JakobThiessen/SmartHome_RelayModul_1Wire_ADC/README.md

# SmartHome_RelayModul_1Wire_ADC

beachte Änderungen in [Hardwarebeschreibung](hardware/readme.md)

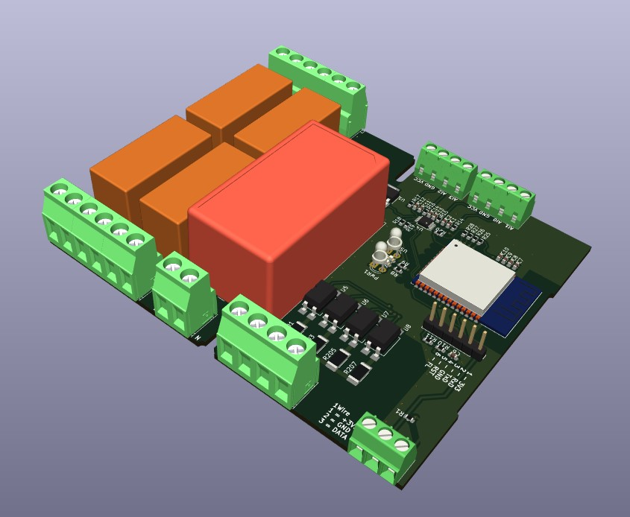
[picture p1: hardware/RelayModul_1Wire_ADC.jpg]
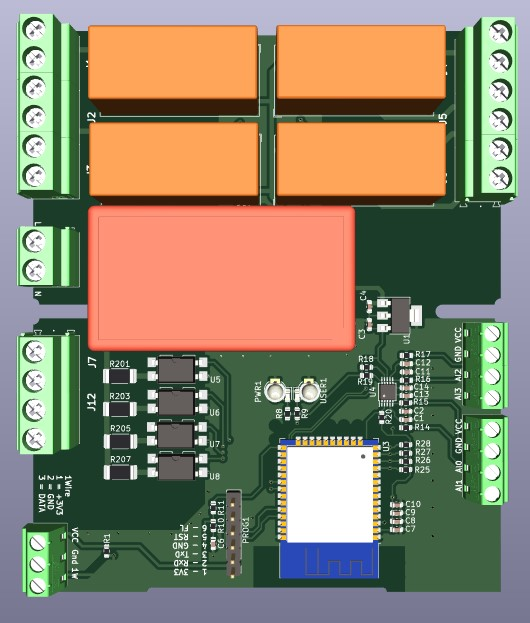
[picture p2: hardware/RelayModul_1Wire_ADC_top.jpg]
  

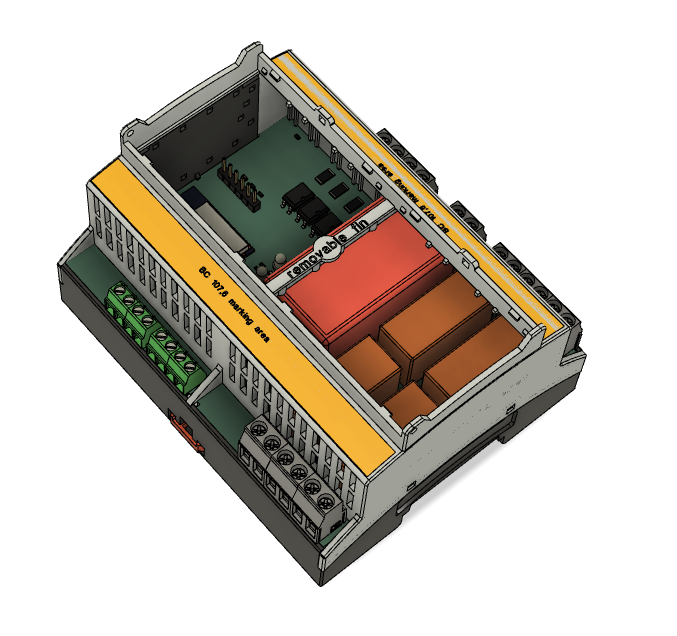
[picture p3: drawings/3d model.png]
