JakobThiessen/SmartHome_RelayModul_1Wire_ADC/hardware/readme.md

# Schaltplan

# Layout

# Bauteile

# Verdrahtungsplan

# Änderungen

Folgende Änderung muss vorgenommen werden:

IO12 kein PullUp (probleme beim booten)

IO34, IO35, IO36 and IO39 --> input only

IO34 --> IO13\
IO35 --> IO25

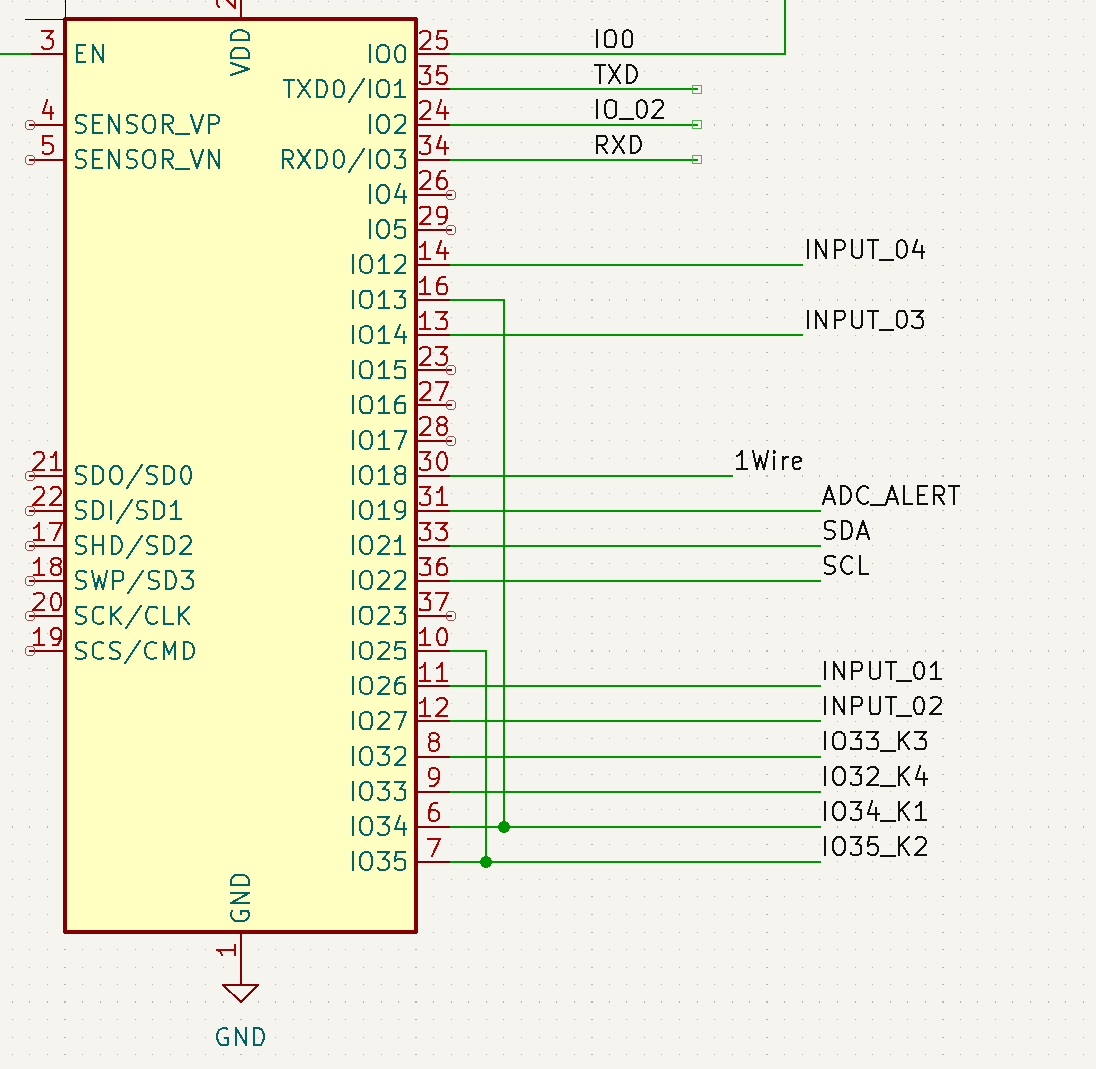
[picture p4: pict/hardware_bug_001.png]
