JakobThiessen/SmartHome_RelayModul_1Wire_ADC/drawings/pxc_2896270_06_06_BC-107-6-UT-HBUS-BK_3D.stp

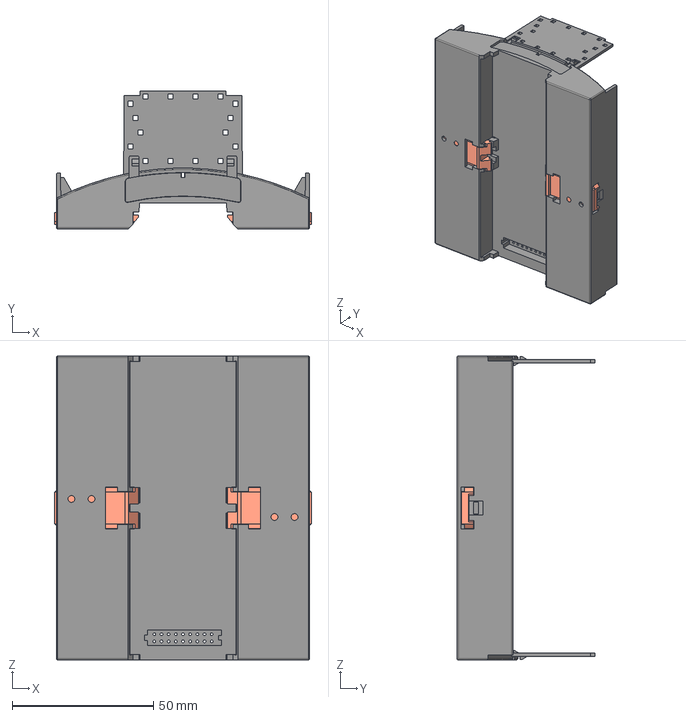
[picture p5: CAD file, 2023-07-21]
drawings/pxc_2896270_06_06_BC-107-6-UT-HBUS-BK_3D.stp
91.0 x 48.9 x 107.6 mm
BC_107.6_GEH-UT_HBUS__H.Select__00383663
Fussriegel_14.4_L30_Sperr_H.Select__00370451_Nr2 x 2
