JakobThiessen/SmartHome_RelayModul_1Wire_ADC/hardware/RelayModul_1Wire_ADC.kicad_pcb

## KiCad design hardware/RelayModul_1Wire_ADC.kicad_pcb (2023-07-30)

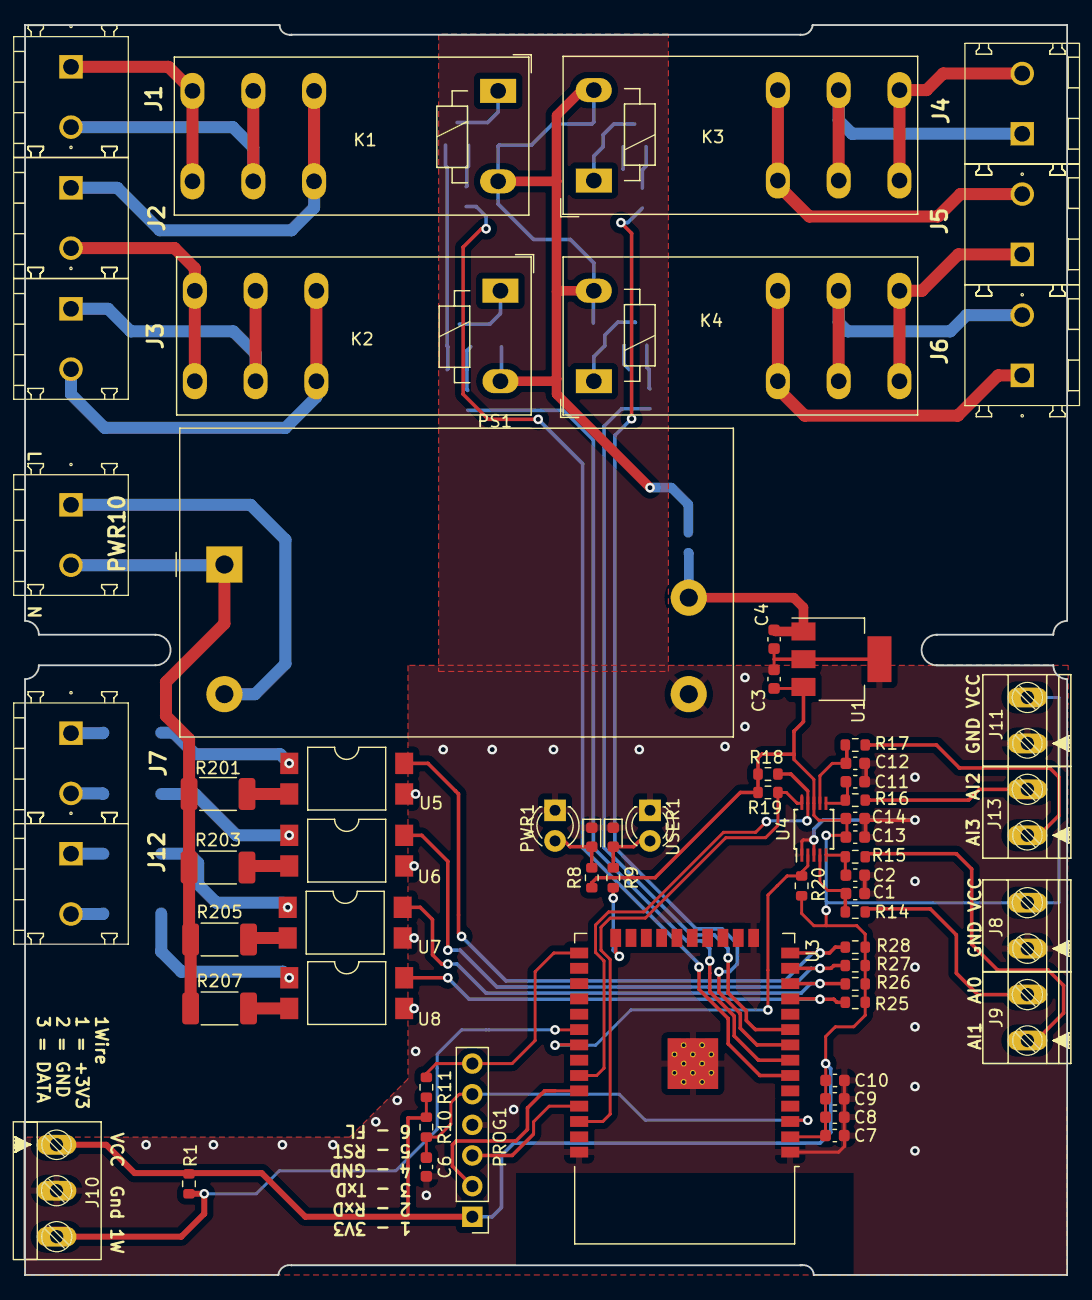
[picture p6: board RelayModul_1Wire_ADC.kicad_pcb from above]

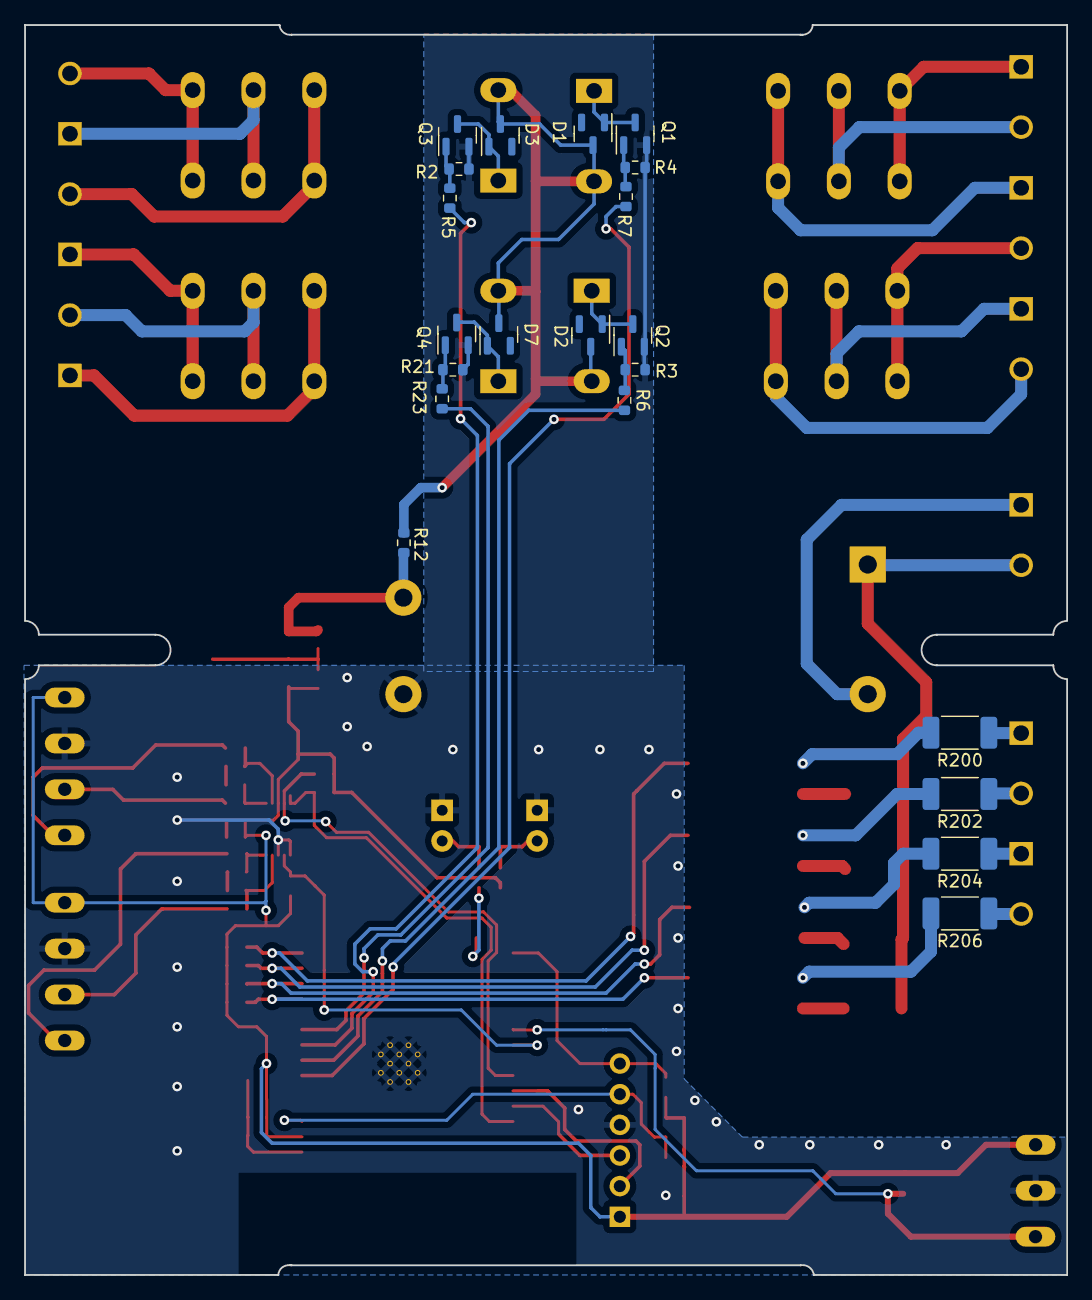
[picture p7: board RelayModul_1Wire_ADC.kicad_pcb from below]

Board: 2 copper layers, 86.4 x 103.6 mm, 85 parts (21 on the bottom side), 65 nets.

Parts:
C1, C2, C6, C7, C8, C11, C12, C13: 100nF; C_0603_1608Metric
C3: 4,7µF/6,3V; C_0603_1608Metric
C4: 10µF/6,3V; C_0603_1608Metric
C9, C10, C14: 1µF; C_0603_1608Metric
D1, D2, D3, D7: BAS21; SOT-23
D4, D5: LED; LED_D3.0mm_Clear
J1, J2, J3, J4, J5, J6, J7, J12: Conn_01x03; MKDSN 2,5-2-5.08
J8, J9, J11, J13: Conn_01x02; MKDS_1_2_3.81
J10: Conn_01x03; MKDS_1_3_3.81
K1, K2, K3, K4: RT314A12; Relay_SPDT_Schrack-RT1-16A-FormC_RM5mm
PROG1: Conn_01x06; PinHeader_1x06_P2.54mm_Vertical
PS1: IRM-05-5; Converter_ACDC_MeanWell_IRM-05-xx_THT
PWR1: green; LED_0603_1608Metric
PWR10: Conn_01x03; MKDSN 2,5-2-5.08
Q1, Q2, Q3, Q4: BSS123; SOT-23
R1: 4k7; R_0603_1608Metric
R2, R3, R4, R21: 100k; R_0603_1608Metric
R5, R6, R7, R14, R15, R16, R17, R23: 100; R_0603_1608Metric
R8, R9: 470R; R_0603_1608Metric
R10, R11, R18, R19, R20, R25, R26, R27, R28: 10k; R_0603_1608Metric
R12: 0R0; R_0603_1608Metric
R200, R201, R202, R203, R204, R205, R206, R207: R; R_2010_5025Metric_Pad1.40x2.65mm_HandSolder
U1: LT1129-3.3_SOT223; SOT-223-3_TabPin2
U3: ESP32-WROOM-32D; ESP32-WROOM-32
U4: ADS1115IDGS; TSSOP-10_3x3mm_P0.5mm
U5, U6, U7, U8: SFH6206-1T; SMDIP-4_W9.53mm_Clearance8mm
USER1: blue; LED_0603_1608Metric

Connections:
+3.3V: C3.1, C7.1, C8.1, C9.1, C10.1, C13.1, C14.1, J8.2, J10.1, J11.2, PROG1.1, R1.1, R8.1, R10.1, R11.1, R18.1, R19.1, R20.1, R25.1, R26.1, R27.1, R28.1, U1.3 (VO), U3.2 (VDD), U4.8 (VDD)
+5V: C4.1, PS1.4 (+Vo), R12.1, U1.1 (VI)
/1Wire: J10.3, R1.2, U3.30 (IO18)
/ADC_ALERT: R20.2, U3.31 (IO19), U4.2 (ALERT/RDY)
/INPUT_01: R25.2, U3.11 (IO26), U8.4
/INPUT_02: R26.2, U3.12 (IO27), U7.4
/INPUT_03: R27.2, U3.13 (IO14), U6.4
/INPUT_04: R28.2, U3.14 (IO12), U5.4
/IO0: PROG1.6, R11.2, U3.25 (IO0)
/IO32_K4: R23.2, U3.9 (IO33)
/IO33_K3: R5.2, U3.8 (IO32)
/IO34_K1: R7.2, U3.6 (IO34)
/IO35_K2: R6.2, U3.7 (IO35)
/IO_02: R9.1, U3.24 (IO2)
/POWER_N: PS1.1 (AC/N), PWR10.2, R201.1, R203.1, R205.1, R207.1
/RST: C6.1, PROG1.5, R10.2, U3.3 (EN)
/RXD: PROG1.2, U3.34 (RXD0/IO3)
/SCL: R19.2, U3.36 (IO22), U4.10 (SCL)
/SDA: R18.2, U3.33 (IO21), U4.9 (SDA)
/TXD: PROG1.3, U3.35 (TXD0/IO1)
GND: C1.2, C2.2, C3.2, C4.2, C6.2, C7.2, C8.2, C9.2, C10.2, C11.2, C12.2, C13.2, C14.2, D4.1 (K), D5.1 (K), J8.1, J10.2, J11.1, PROG1.4, PS1.3 (-Vo), PWR1.1 (K), Q1.2 (S), Q2.2 (S), Q3.2 (S), Q4.2 (S), R2.2, R3.2, R4.2, R21.2, U1.2 (GND), U3.1 (GND), U3.15 (GND), U3.38 (GND), U3.39 (GND), U4.1 (ADDR), U4.3 (GND), U5.3, U6.3, U7.3, U8.3, USER1.1 (K)
unnamed: D1.1 (A), K1.A1, Q1.3 (D)
unnamed: D2.1 (A), K2.A1, Q2.3 (D)
unnamed: D3.1 (A), K3.A1, Q3.3 (D)
unnamed: D4.2 (A), PWR1.2 (A), R8.2
unnamed: D5.2 (A), R9.2, USER1.2 (A)
unnamed: D7.1 (A), K4.A1, Q4.3 (D)
unnamed: J1.1, K1.14
unnamed: J1.2, K1.11
unnamed: J2.1, K1.12
unnamed: J2.2, K2.14
unnamed: J3.1, K2.11
unnamed: J3.2, K2.12
unnamed: J4.1, K3.11
unnamed: J4.2, K3.14
unnamed: J5.1, K4.14
unnamed: J5.2, K3.12
unnamed: J6.1, K4.12
unnamed: J6.2, K4.11
unnamed: J7.1, R200.1
unnamed: J7.2, R202.1
unnamed: J9.1, R15.1
unnamed: J9.2, R14.1
unnamed: J12.1, R204.1
unnamed: J12.2, R206.1
unnamed: J13.1, R17.1
unnamed: J13.2, R16.1
unnamed: PS1.2 (AC/L), PWR10.1
unnamed: Q1.1 (G), R4.1, R7.1
unnamed: Q2.1 (G), R3.1, R6.1
unnamed: Q3.1 (G), R2.1, R5.1
unnamed: Q4.1 (G), R21.1, R23.1
unnamed: R200.2, U5.1
unnamed: R201.2, U5.2
unnamed: R202.2, U6.1
unnamed: R203.2, U6.2
unnamed: R204.2, U7.1
unnamed: R205.2, U7.2
unnamed: R206.2, U8.1
unnamed: R207.2, U8.2
unnamed: C1.1, R14.2, U4.4 (AIN0)
unnamed: C2.1, R15.2, U4.5 (AIN1)
unnamed: C11.1, R16.2, U4.6 (AIN2)
unnamed: C12.1, R17.2, U4.7 (AIN3)
Vdrive: D1.3 (K), D2.3 (K), D3.3 (K), D7.3 (K), K1.A2, K2.A2, K3.A2, K4.A2, R12.2
