JakobThiessen/SmartHome_RelayModul_1Wire_ADC/(commit log)

2023-07-08 Schaltplan angepasst
    [Input.kicad_sch, RealyModul_1Wire_ADC.kicad_pcb, RealyModul_1Wire_ADC.kicad_sch, Relay.kicad_sch]
2023-07-20 änderung
    [Input.kicad_sch, RealyModul_1Wire_ADC.kicad_pcb, RealyModul_1Wire_ADC.kicad_sch, Relay.kicad_sch]
2023-07-21 fast fertig
    [Input.kicad_sch, RealyModul_1Wire_ADC.kicad_pcb, RealyModul_1Wire_ADC.kicad_sch, Relay.kicad_sch, pxc_2896270_06_06_BC-107-6-UT-HBUS-BK_3D.stp]
2023-07-30 create gerber file
    [RealyModul_1Wire_ADC-B_Cu.gbl, RealyModul_1Wire_ADC-B_Mask.gbs, RealyModul_1Wire_ADC-B_Silkscreen.gbo, RealyModul_1Wire_ADC-Edge_Cuts.gm1, RealyModul_1Wire_ADC-F_Cu.gtl, RealyModul_1Wire_ADC-F_Mask.gts, RealyModul_1Wire_ADC-F_Silkscreen.gto, RealyModul_1Wire_ADC-NPTH-drl_map.gbr]
2023-07-30 rename files: from "RealyModul_1Wire_ADC" to "RelayModul_1Wire_ADC"
    [RealyModul_1Wire_ADC.kicad_pcb, RealyModul_1Wire_ADC.kicad_sch]
